cmmakerclub/Solar-cell-MPPT_Arduino/Pictrue/Lamp 12V 50W test with 10W solarcell/1.2A with MPPT.jpg

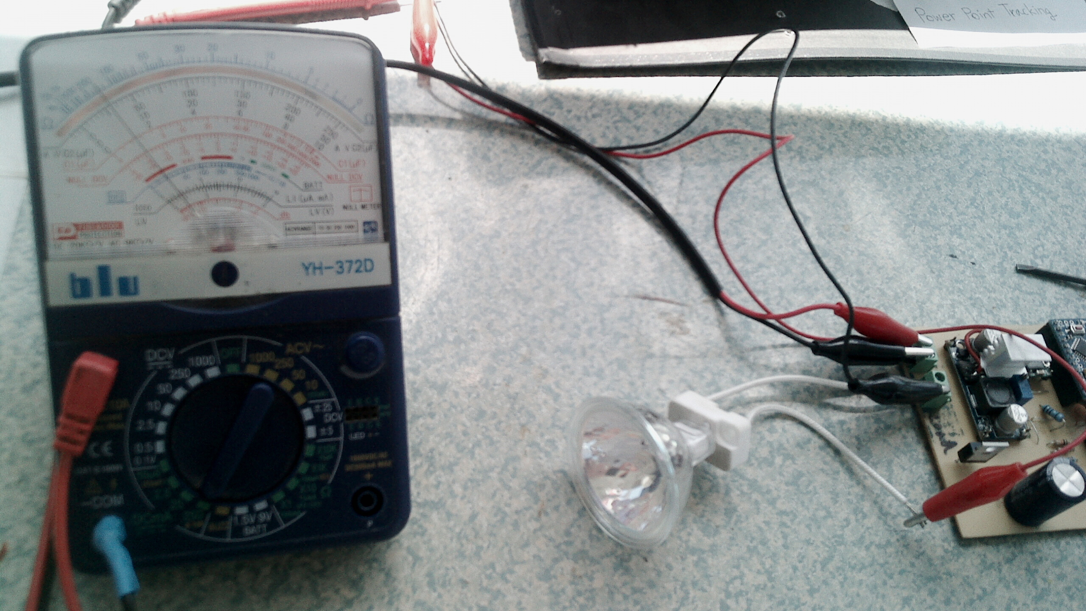
Pictrue/Lamp 12V 50W test with 10W solarcell/1.2A with MPPT.jpg
