cmmakerclub/Solar-cell-MPPT_Arduino/SolarsellMPPT/PCB.pdf

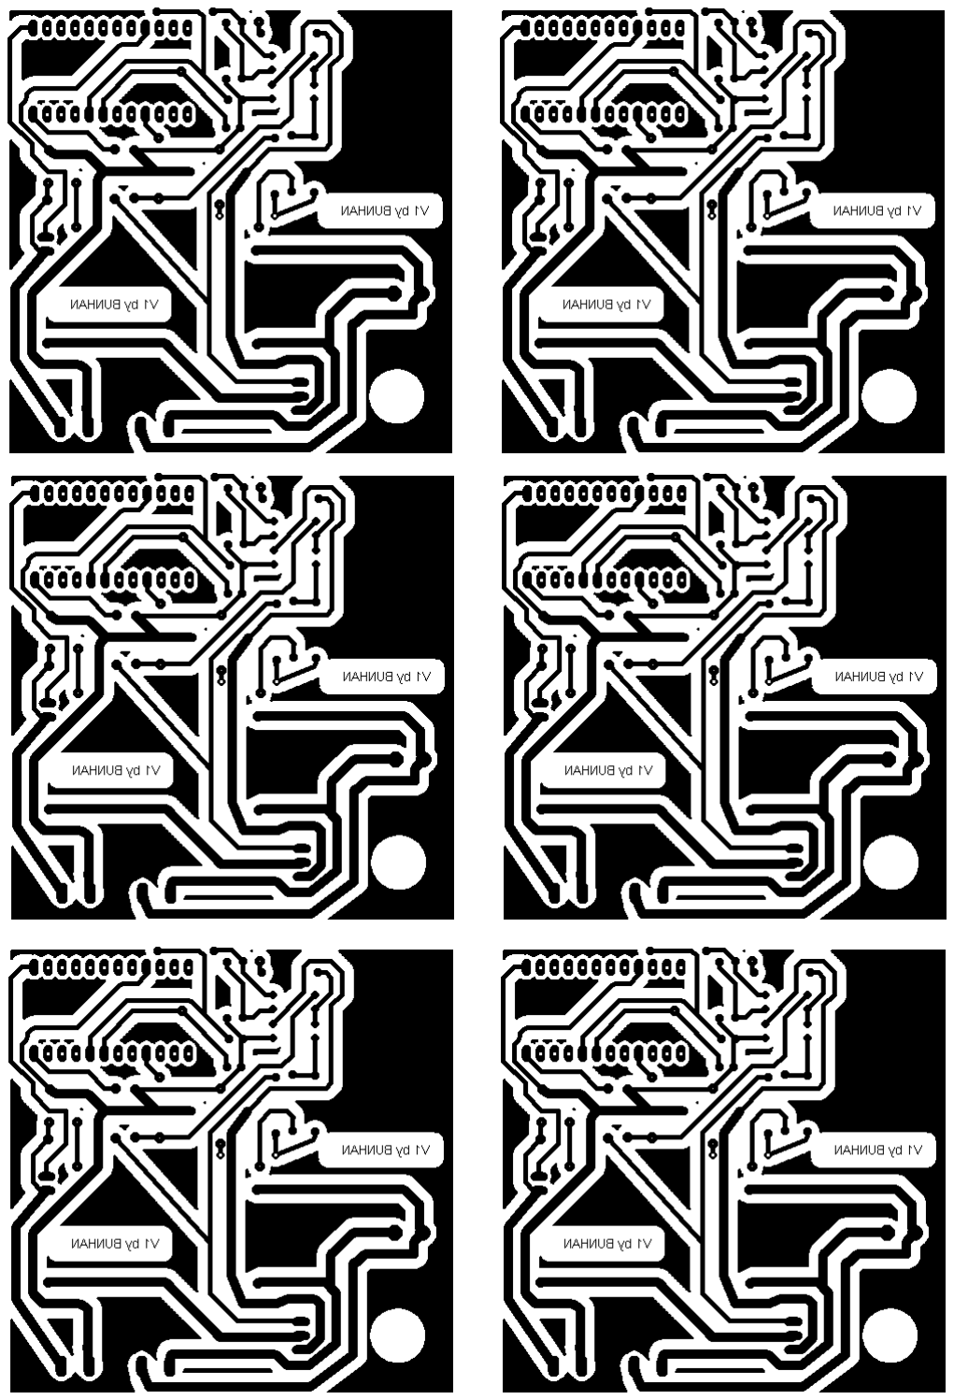
[picture p9: page 1]
