cmmakerclub/Solar-cell-MPPT_Arduino/SolarsellMPPT/Jumper.png

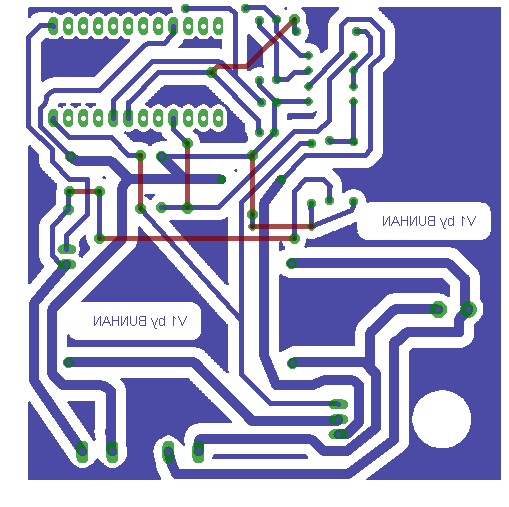
SolarsellMPPT/Jumper.png
