cmmakerclub/Solar-cell-MPPT_Arduino/SolarsellMPPT/วงจร.png

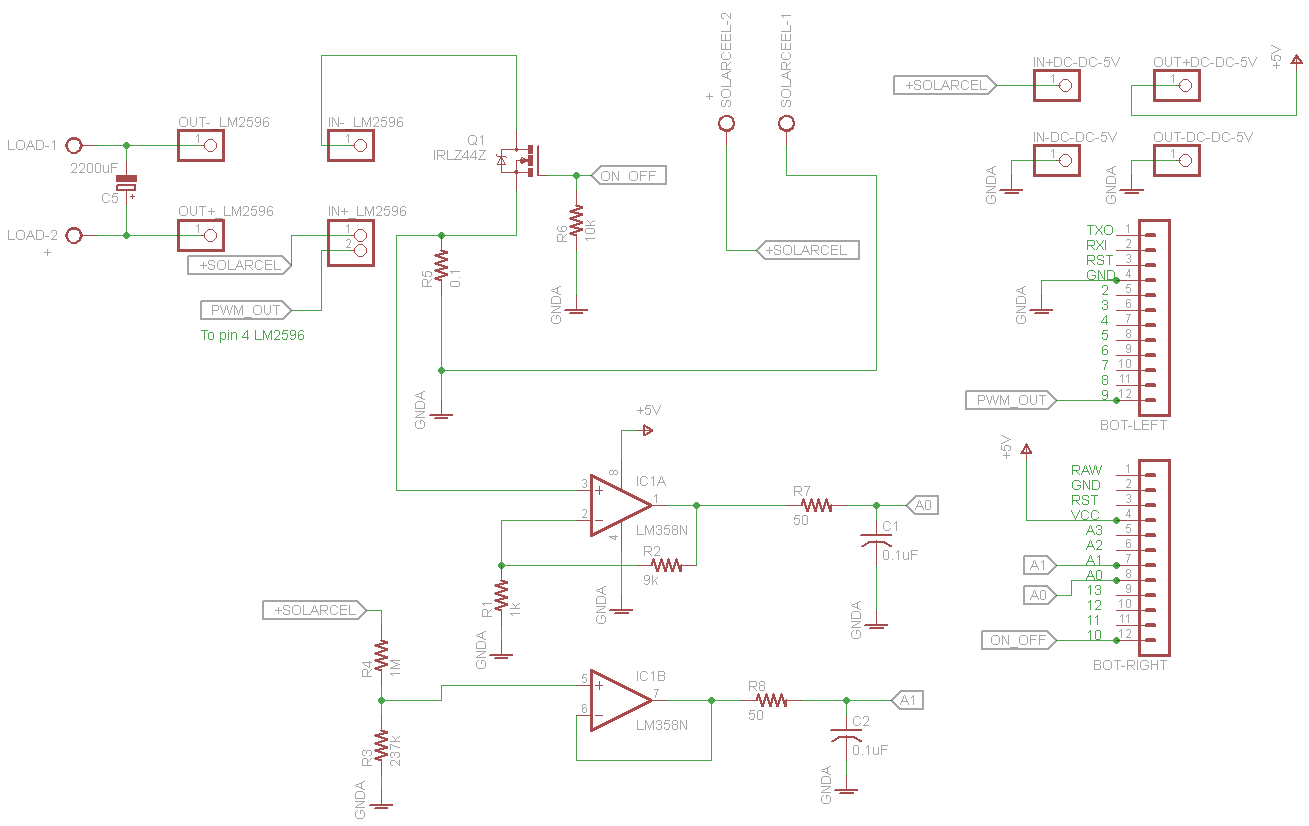
SolarsellMPPT/วงจร.png
