cmmakerclub/Solar-cell-MPPT_Arduino/SolarsellMPPT/Arduino-mini-328-Sch.brd

## EAGLE design SolarsellMPPT/Arduino-mini-328-Sch.brd (2015-01-10)

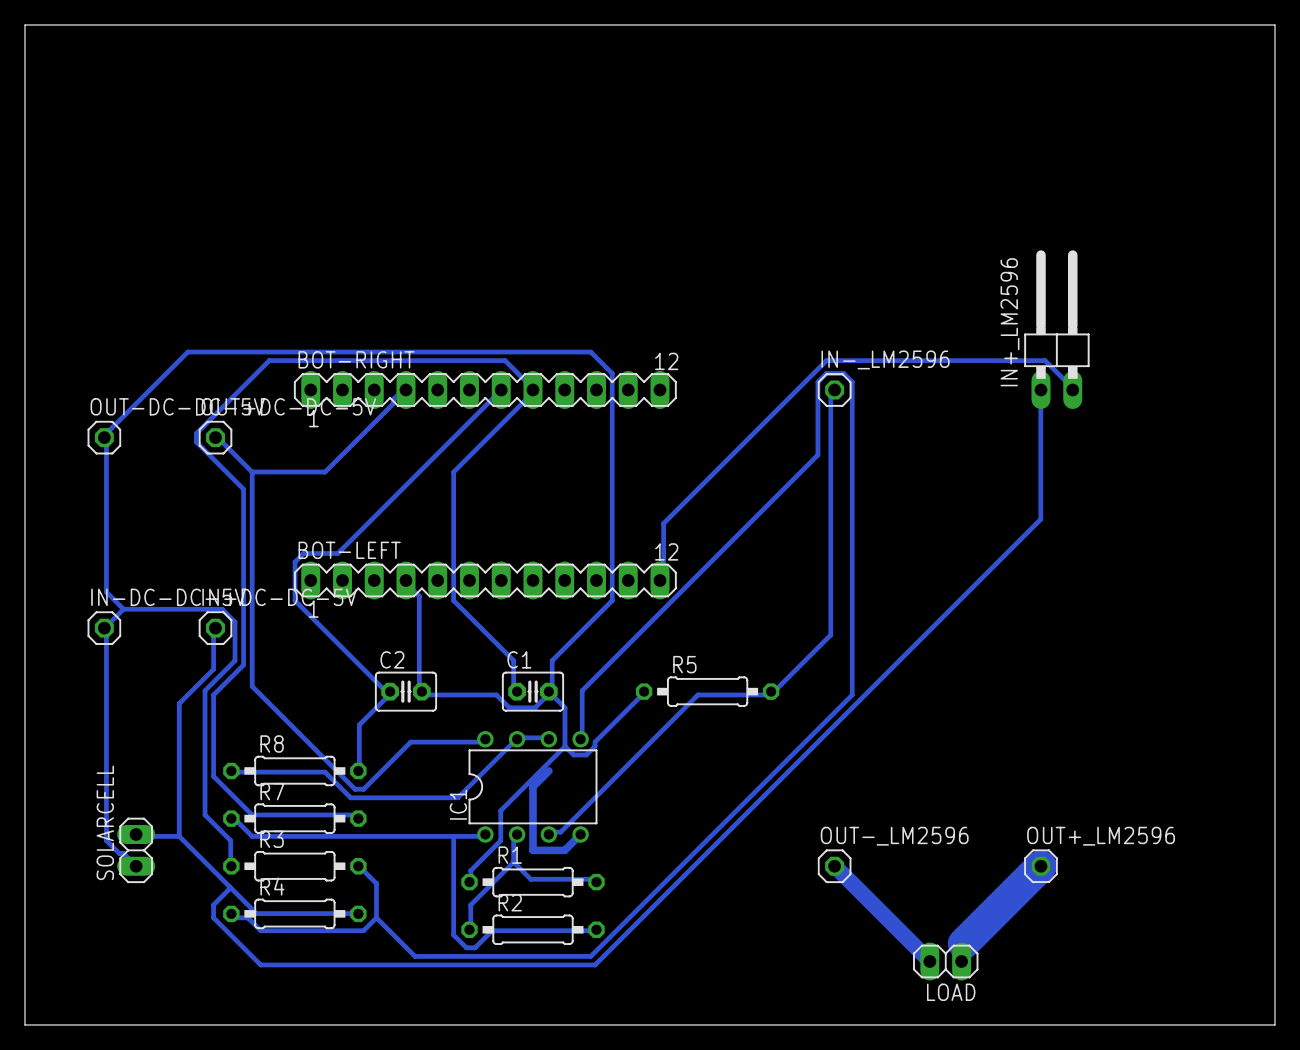
[picture p12: board Arduino-mini-328-Sch.brd from above]

Board: 2 copper layers, 100.0 x 80.0 mm, 22 parts (0 on the bottom side), 12 nets.

Parts:
BOT-LEFT: MA12-1
BOT-RIGHT: MA12-1
C1, C2: 0.1uF; C025-030X050
IC1: LM358N; DIL08
IN+DC-DC-5V: 1X01
IN+_LM2596: 1X02/90
IN-DC-DC-5V: 1X01
IN-_LM2596: 1X01
LOAD: 1X02
OUT+DC-DC-5V: 1X01
OUT+_LM2596: 1X01
OUT-DC-DC-5V: 1X01
OUT-_LM2596: 1X01
R1: 1k; 0207/10
R2: 9k; 0207/10
R3: 237k; 0207/10
R4: 1M; 0207/10
R5: 0.1; 0207/10
R7, R8: 50; 0207/10
SOLARCELL: 1X02

Connections:
GNDA: BOT-LEFT.4, C1.2, C2.2, IN-DC-DC-5V.1, OUT-DC-DC-5V.1, R1.1, R3.1, R5.1, SOLARCELL.1
unnamed: IC1.1, R2.2, R7.1
unnamed: IC1.2, R1.2, R2.1
unnamed: BOT-LEFT.12, IN+_LM2596.2
unnamed: IC1.6, IC1.7, R8.1
unnamed: IC1.3, IN-_LM2596.1, R5.2
unnamed: BOT-RIGHT.8, C1.1, R7.2
unnamed: BOT-RIGHT.7, C2.1, R8.2
unnamed: IN+DC-DC-5V.1, IN+_LM2596.1, R4.2, SOLARCELL.2
unnamed: IC1.5, R3.2, R4.1
unnamed: LOAD.2, OUT-_LM2596.1
V+: BOT-RIGHT.4, IC1.8, OUT+DC-DC-5V.1
