cmmakerclub/Solar-cell-MPPT_Arduino/Pictrue/Lamp 12V 50W test with 10W solarcell/0.6A when direct solarcell.jpg

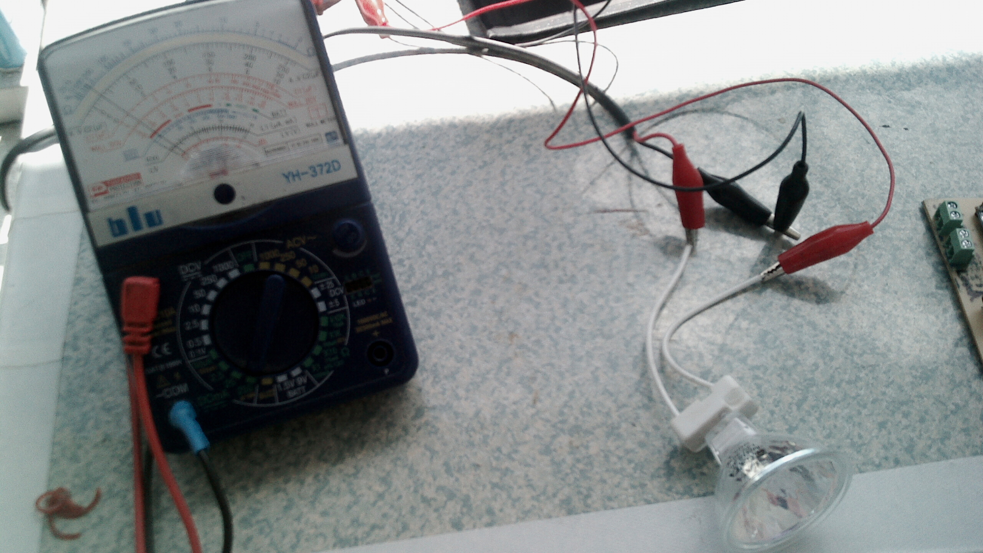
Pictrue/Lamp 12V 50W test with 10W solarcell/0.6A when direct solarcell.jpg
