cmmakerclub/Solar-cell-MPPT_Arduino/Pictrue/Lamp 12V 50W test with 10W solarcell/Lamp haven't light if direct Solarcell.jpg

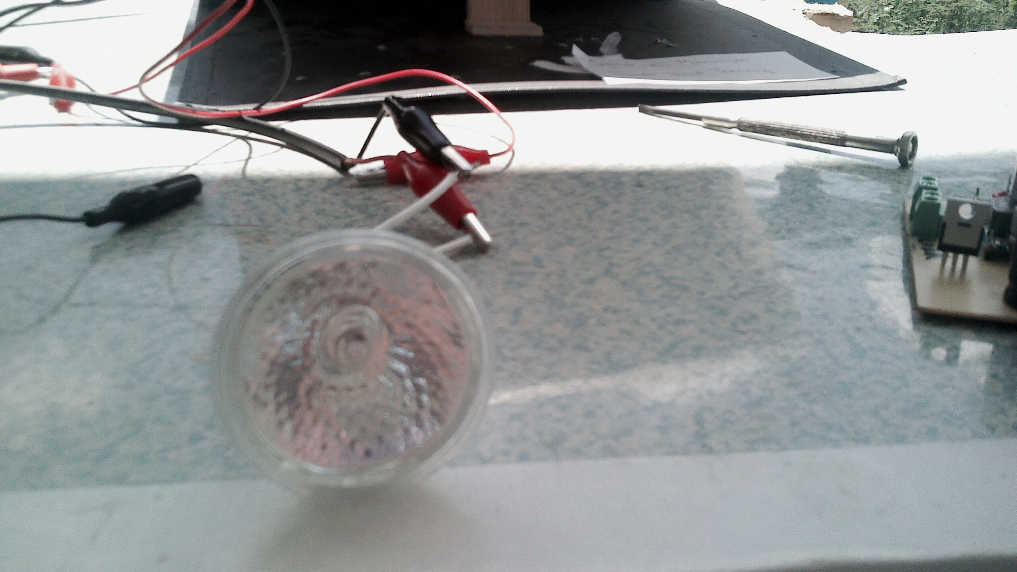
Pictrue/Lamp 12V 50W test with 10W solarcell/Lamp haven't light if direct Solarcell.jpg
