cmmakerclub/Solar-cell-MPPT_Arduino/(commit log)

2014-12-19 update data test and code
    [Solasell-data.xlsx]
2014-12-25 Ver1.2 add new code and chaged PWM Fr
2014-12-27 up pic วงจร
2014-12-30 อัพเดทบทความ
2015-01-05 อัพเดทบทความ เพิ่มโฟลวชาร์จการทำงาน จัดหน้า
2015-01-09 PCB and Sch use IRL2203 to drive load
    [Arduino-mini-328-Sch.brd, Arduino-mini-328-Sch.sch]
2015-01-09 update วงจรเขียนใน Engle
2015-01-10 update Shc and PCB . use LM2596 to drive load
    [Arduino-mini-328-Sch.sch]
2015-01-10 chage some PCB
    [Arduino-mini-328-Sch.brd]
2015-06-11 Update new shc PBC
    [Sch.brd, Sch.sch, Solasell-data.xlsx]
2015-06-12 Fix PCB
2015-06-14 Update ผลการทดลอง รูป
